usamajaved1305/80kw-pv-bess-autocad-dispatch/(list of files, cad)

Other CAD files:
drawings/PV-01 Mechanical Layout.dxf
drawings/PV-04 Single Line Diagram.dxf
drawings/PV-03 Battery Control and Performance.dxf
drawings/PV-01 Mechanical Layout.dwg
drawings/PV-03 Battery Control and Performance.dwg
drawings/PV-04 Single Line Diagram.dwg
