usamajaved1305/80kw-pv-bess-autocad-dispatch/drawings/PV-03 Battery Control and Performance.pdf

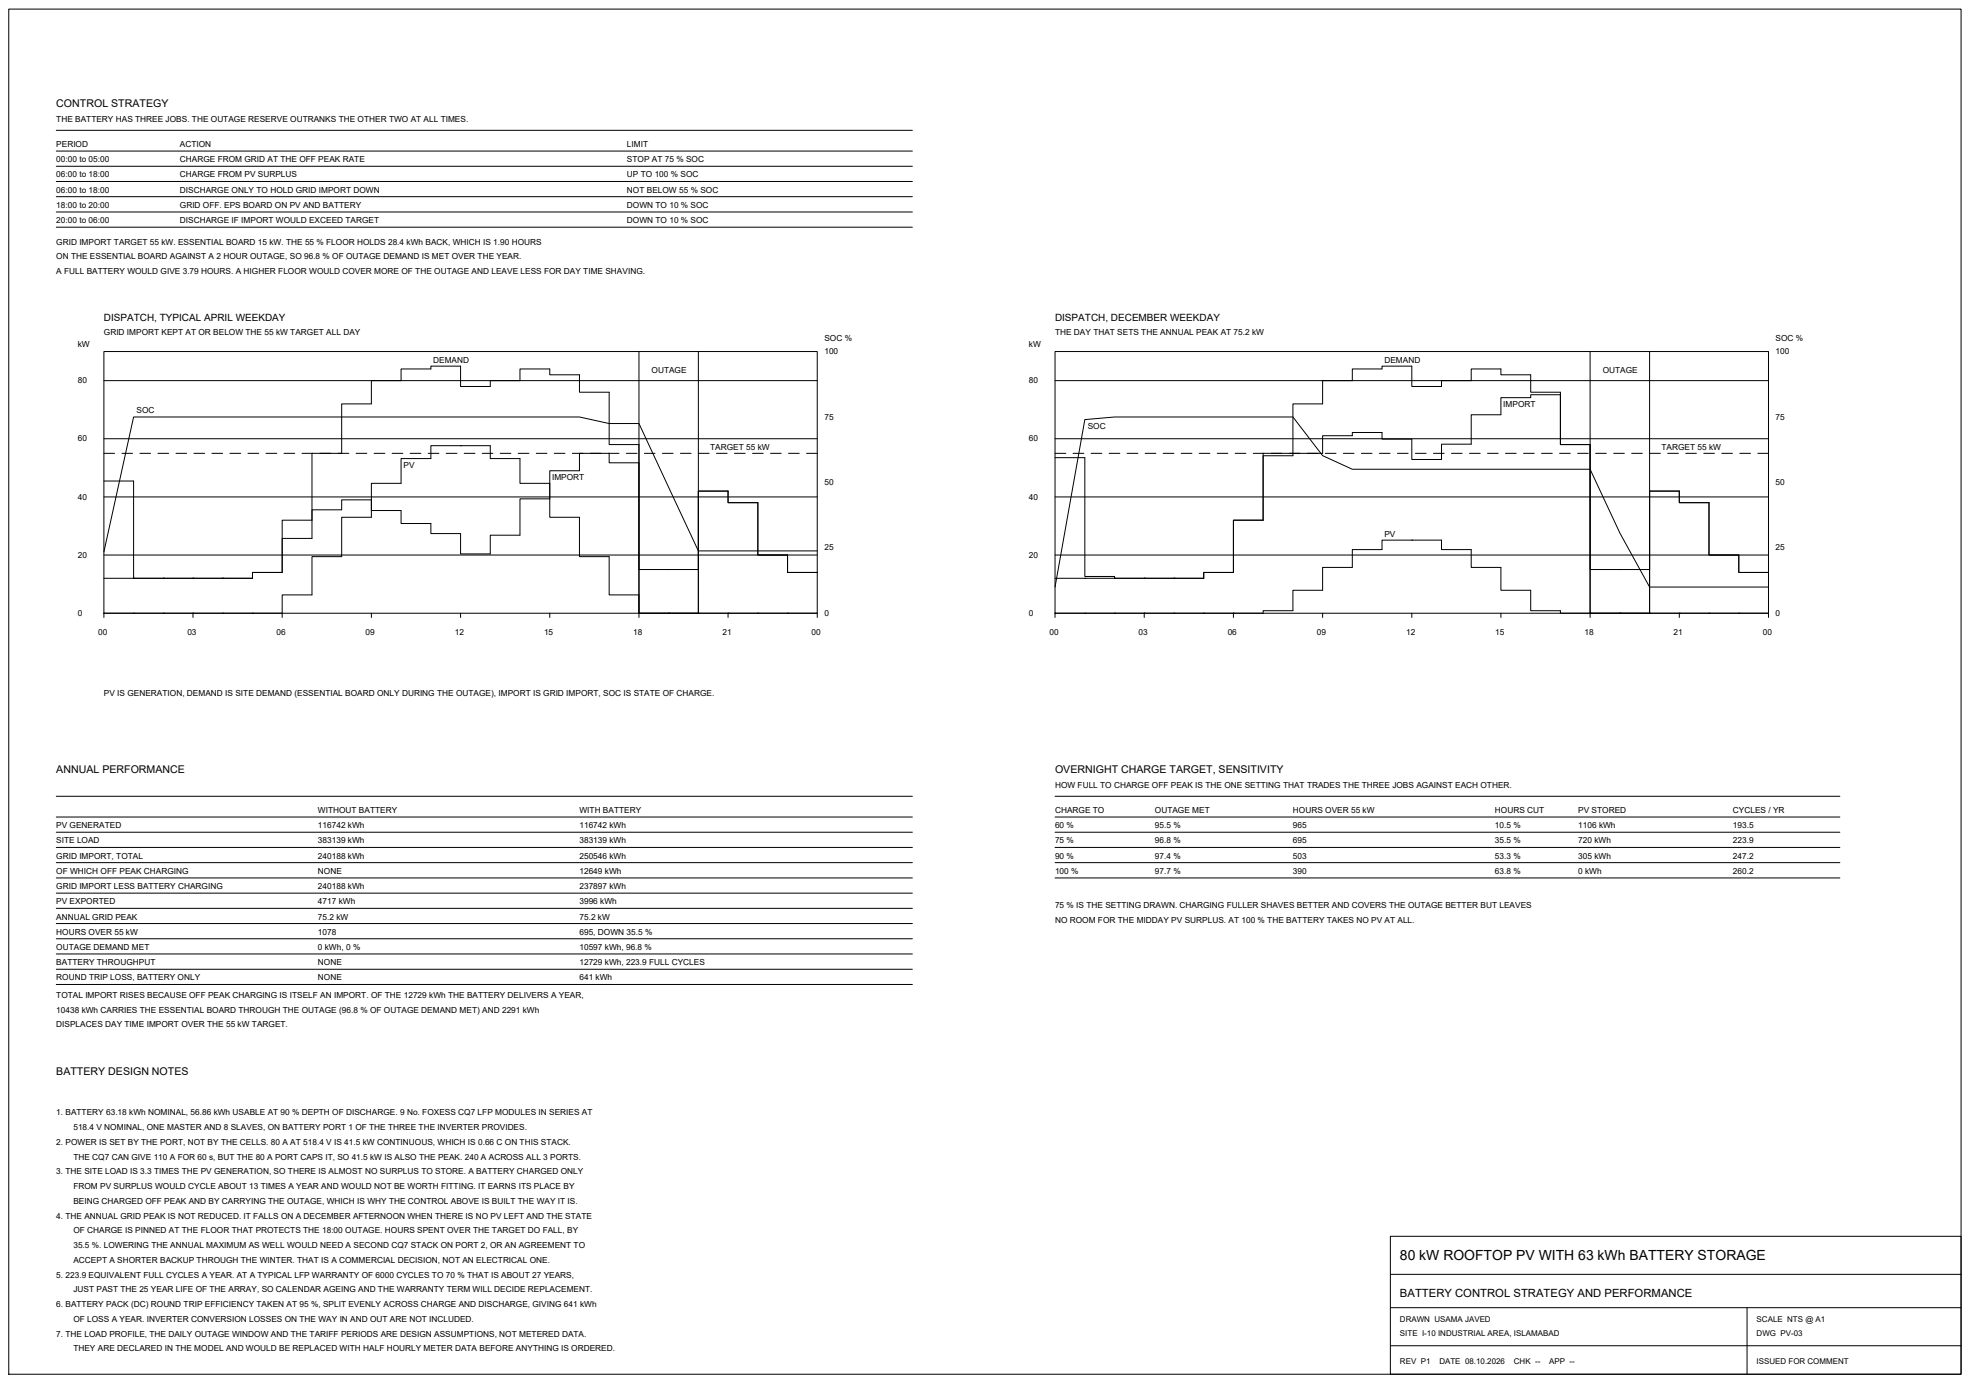
[picture p8: page 1]
CONTROL STRATEGY; CHARGE FROM GRID AT THE OFF PEAK RATE; STOP AT 75 % SOC; CHARGE FROM PV SURPLUS; UP TO 100 % SOC; DISCHARGE ONLY TO HOLD GRID IMPORT DOWN; NOT BELOW 55 % SOC; GRID OFF. EPS BOARD ON PV AND BATTERY; DOWN TO 10 % SOC; DISCHARGE IF IMPORT WOULD EXCEED TARGET; SOC %; TARGET 55 kW; ANNUAL PERFORMANCE; WITHOUT BATTERY; WITH BATTERY; PV GENERATED; 116742 kWh; SITE LOAD; 383139 kWh; GRID IMPORT, TOTAL; 240188 kWh; 250546 kWh; OF WHICH OFF PEAK CHARGING; NONE; 12649 kWh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

THE BATTERY HAS THREE JOBS. THE OUTAGE RESERVE OUTRANKS THE OTHER TWO AT ALL TIMES.

GRID IMPORT TARGET 55 kW. ESSENTIAL BOARD 15 kW. THE 55 % FLOOR HOLDS 28.4 kWh BACK, WHICH IS 1.90 HOURS
ON THE ESSENTIAL BOARD AGAINST A 2 HOUR OUTAGE, SO 96.8 % OF OUTAGE DEMAND IS MET OVER THE YEAR.
A FULL BATTERY WOULD GIVE 3.79 HOURS. A HIGHER FLOOR WOULD COVER MORE OF THE OUTAGE AND LEAVE LESS FOR DAY TIME SHAVING.

DISPATCH, TYPICAL APRIL WEEKDAY

DISPATCH, DECEMBER WEEKDAY

GRID IMPORT KEPT AT OR BELOW THE 55 kW TARGET ALL DAY

THE DAY THAT SETS THE ANNUAL PEAK AT 75.2 kW

PV IS GENERATION, DEMAND IS SITE DEMAND (ESSENTIAL BOARD ONLY DURING THE OUTAGE), IMPORT IS GRID IMPORT, SOC IS STATE OF CHARGE.

OVERNIGHT CHARGE TARGET, SENSITIVITY

HOW FULL TO CHARGE OFF PEAK IS THE ONE SETTING THAT TRADES THE THREE JOBS AGAINST EACH OTHER.

75 % IS THE SETTING DRAWN. CHARGING FULLER SHAVES BETTER AND COVERS THE OUTAGE BETTER BUT LEAVES
NO ROOM FOR THE MIDDAY PV SURPLUS. AT 100 % THE BATTERY TAKES NO PV AT ALL.

TOTAL IMPORT RISES BECAUSE OFF PEAK CHARGING IS ITSELF AN IMPORT. OF THE 12729 kWh THE BATTERY DELIVERS A YEAR,
10438 kWh CARRIES THE ESSENTIAL BOARD THROUGH THE OUTAGE (96.8 % OF OUTAGE DEMAND MET) AND 2291 kWh
DISPLACES DAY TIME IMPORT OVER THE 55 kW TARGET.

BATTERY DESIGN NOTES

1. BATTERY 63.18 kWh NOMINAL, 56.86 kWh USABLE AT 90 % DEPTH OF DISCHARGE. 9 No. FOXESS CQ7 LFP MODULES IN SERIES AT
518.4 V NOMINAL, ONE MASTER AND 8 SLAVES, ON BATTERY PORT 1 OF THE THREE THE INVERTER PROVIDES.
2. POWER IS SET BY THE PORT, NOT BY THE CELLS. 80 A AT 518.4 V IS 41.5 kW CONTINUOUS, WHICH IS 0.66 C ON THIS STACK.
THE CQ7 CAN GIVE 110 A FOR 60 s, BUT THE 80 A PORT CAPS IT, SO 41.5 kW IS ALSO THE PEAK. 240 A ACROSS ALL 3 PORTS.
3. THE SITE LOAD IS 3.3 TIMES THE PV GENERATION, SO THERE IS ALMOST NO SURPLUS TO STORE. A BATTERY CHARGED ONLY
FROM PV SURPLUS WOULD CYCLE ABOUT 13 TIMES A YEAR AND WOULD NOT BE WORTH FITTING. IT EARNS ITS PLACE BY
BEING CHARGED OFF PEAK AND BY CARRYING THE OUTAGE, WHICH IS WHY THE CONTROL ABOVE IS BUILT THE WAY IT IS.
4. THE ANNUAL GRID PEAK IS NOT REDUCED. IT FALLS ON A DECEMBER AFTERNOON WHEN THERE IS NO PV LEFT AND THE STATE
OF CHARGE IS PINNED AT THE FLOOR THAT PROTECTS THE 18:00 OUTAGE. HOURS SPENT OVER THE TARGET DO FALL, BY
35.5 %. LOWERING THE ANNUAL MAXIMUM AS WELL WOULD NEED A SECOND CQ7 STACK ON PORT 2, OR AN AGREEMENT TO
ACCEPT A SHORTER BACKUP THROUGH THE WINTER. THAT IS A COMMERCIAL DECISION, NOT AN ELECTRICAL ONE.
5. 223.9 EQUIVALENT FULL CYCLES A YEAR. AT A TYPICAL LFP WARRANTY OF 6000 CYCLES TO 70 % THAT IS ABOUT 27 YEARS,
JUST PAST THE 25 YEAR LIFE OF THE ARRAY, SO CALENDAR AGEING AND THE WARRANTY TERM WILL DECIDE REPLACEMENT.
6. BATTERY PACK (DC) ROUND TRIP EFFICIENCY TAKEN AT 95 %, SPLIT EVENLY ACROSS CHARGE AND DISCHARGE, GIVING 641 kWh
OF LOSS A YEAR. INVERTER CONVERSION LOSSES ON THE WAY IN AND OUT ARE NOT INCLUDED.
7. THE LOAD PROFILE, THE DAILY OUTAGE WINDOW AND THE TARIFF PERIODS ARE DESIGN ASSUMPTIONS, NOT METERED DATA.
THEY ARE DECLARED IN THE MODEL AND WOULD BE REPLACED WITH HALF HOURLY METER DATA BEFORE ANYTHING IS ORDERED.

80 kW ROOFTOP PV WITH 63 kWh BATTERY STORAGE

BATTERY CONTROL STRATEGY AND PERFORMANCE

DRAWN USAMA JAVED SITE I-10 INDUSTRIAL AREA, ISLAMABAD | SCALE NTS @ A1 DWG PV-03

REV P1 DATE 08.10.2026 CHK -- APP -- | ISSUED FOR COMMENT
