usamajaved1305/80kw-pv-bess-autocad-dispatch/drawings/PV-01 Mechanical Layout.pdf

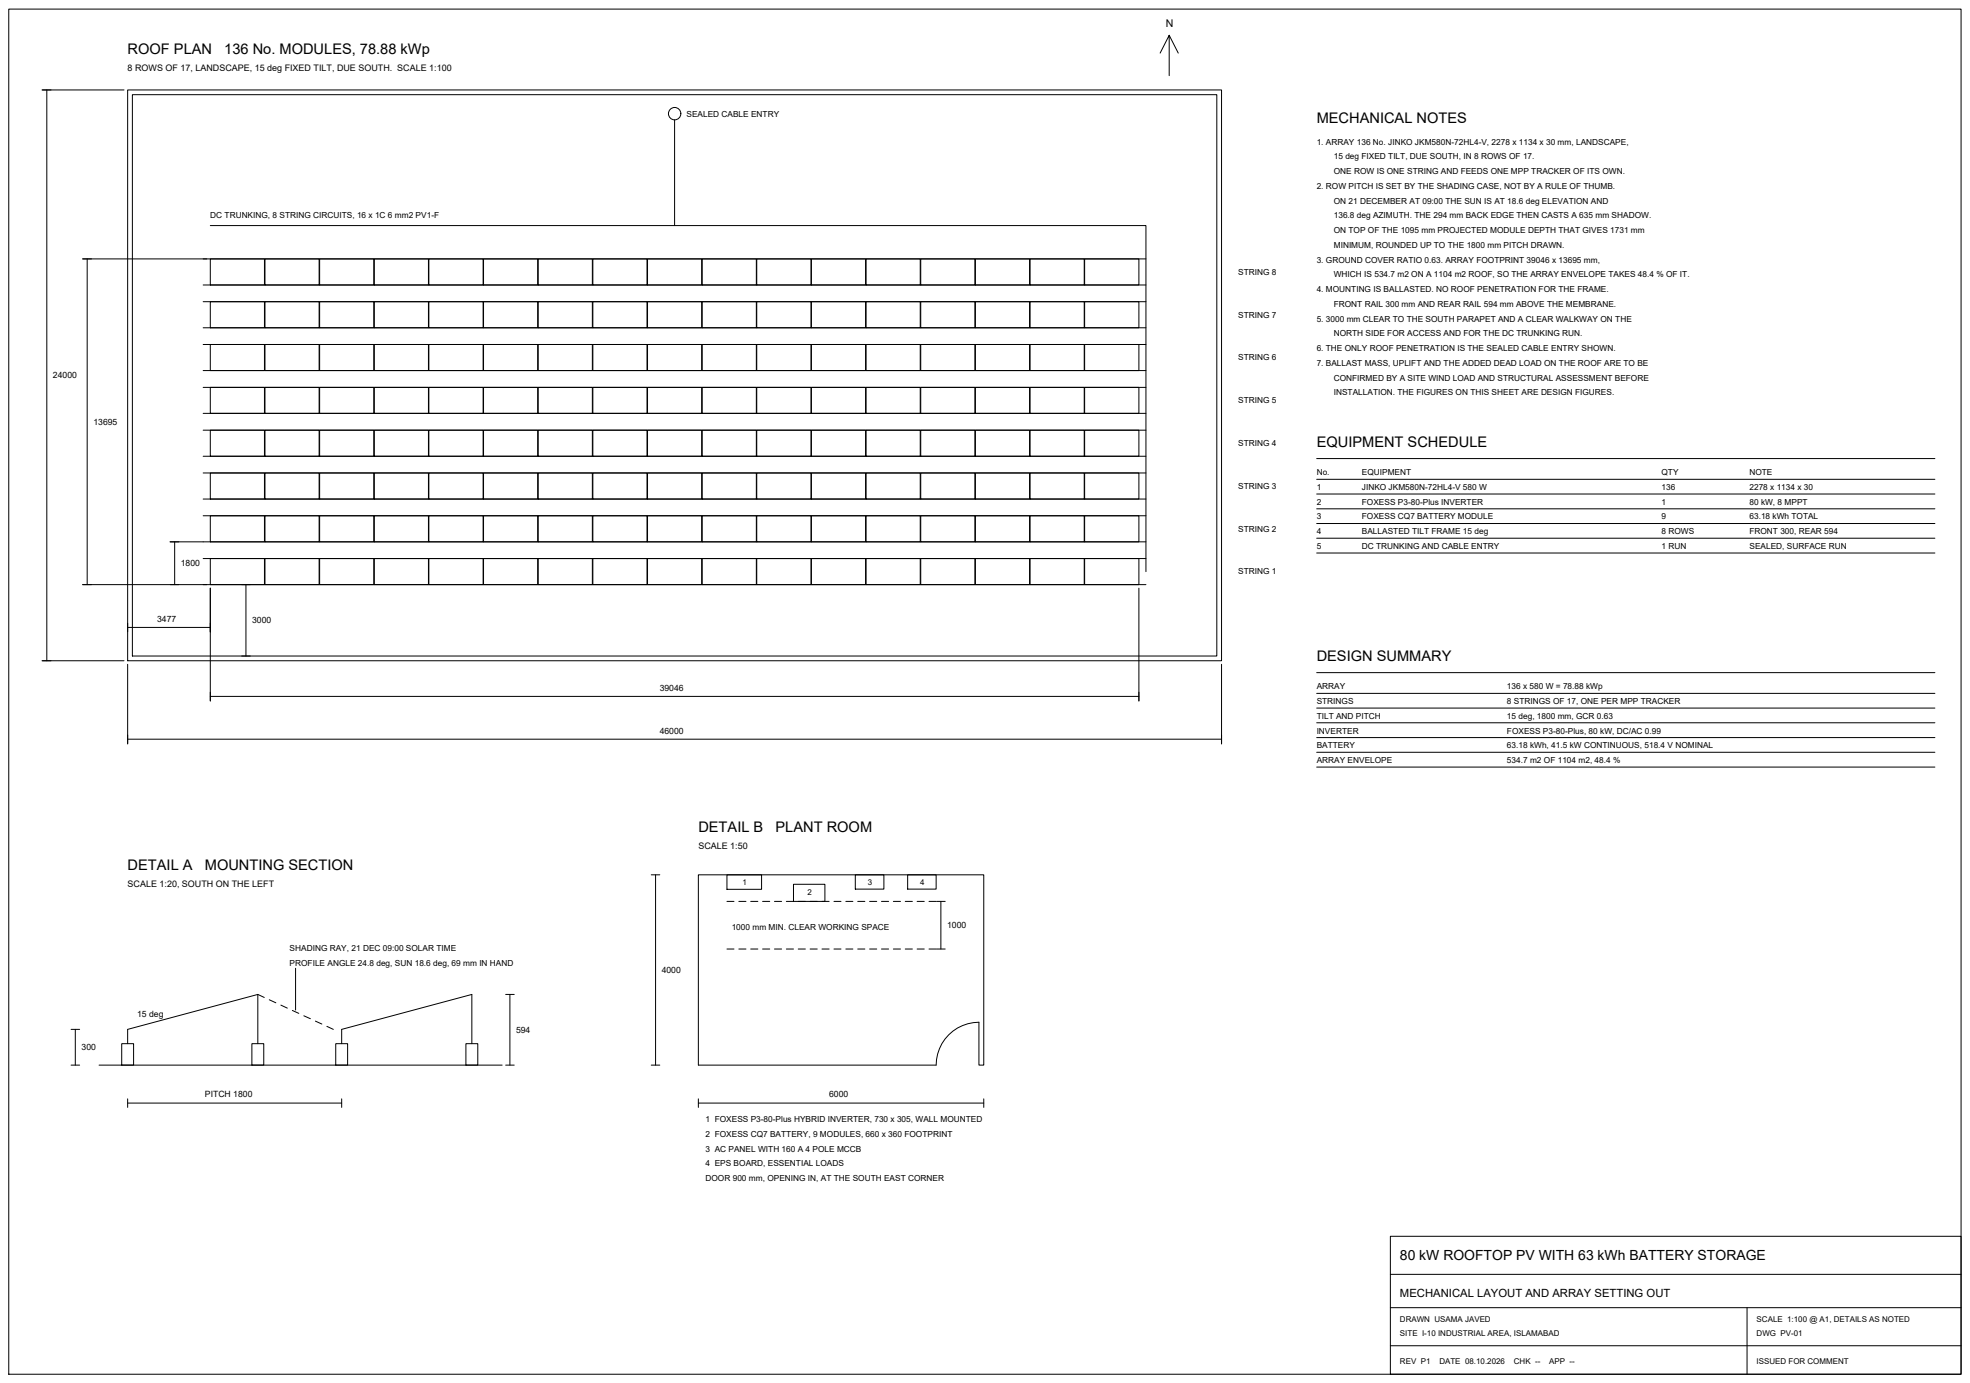
[picture p9: page 1]
STRING 1; STRING 2; STRING 3; STRING 4; STRING 5; STRING 6; STRING 7; STRING 8; 15 deg; PITCH 1800; SCALE 1:50; MECHANICAL NOTES; EQUIPMENT SCHEDULE; JINKO JKM580N-72HL4-V 580 W; FOXESS P3-80-Plus INVERTER; 80 kW, 8 MPPT; FOXESS CQ7 BATTERY MODULE; 63.18 kWh TOTAL; BALLASTED TILT FRAME 15 deg; 8 ROWS; FRONT 300, REAR 594; DC TRUNKING AND CABLE ENTRY; 1 RUN; SEALED, SURFACE RUN; DESIGN SUMMARY; ARRAY; 136 x 580 W = 78.88 kWp; STRINGS; 8 STRINGS OF 17, ONE PER MPP TRACKER; TILT AND PITCH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

ROOF PLAN 136 No. MODULES, 78.88 kWp

8 ROWS OF 17, LANDSCAPE, 15 deg FIXED TILT, DUE SOUTH. SCALE 1:100

SEALED CABLE ENTRY

1. ARRAY 136 No. JINKO JKM580N-72HL4-V, 2278 x 1134 x 30 mm, LANDSCAPE,
15 deg FIXED TILT, DUE SOUTH, IN 8 ROWS OF 17.
ONE ROW IS ONE STRING AND FEEDS ONE MPP TRACKER OF ITS OWN.
2. ROW PITCH IS SET BY THE SHADING CASE, NOT BY A RULE OF THUMB.
ON 21 DECEMBER AT 09:00 THE SUN IS AT 18.6 deg ELEVATION AND
136.8 deg AZIMUTH. THE 294 mm BACK EDGE THEN CASTS A 635 mm SHADOW.
ON TOP OF THE 1095 mm PROJECTED MODULE DEPTH THAT GIVES 1731 mm
MINIMUM, ROUNDED UP TO THE 1800 mm PITCH DRAWN.
3. GROUND COVER RATIO 0.63. ARRAY FOOTPRINT 39046 x 13695 mm,
WHICH IS 534.7 m2 ON A 1104 m2 ROOF, SO THE ARRAY ENVELOPE TAKES 48.4 % OF IT.
4. MOUNTING IS BALLASTED. NO ROOF PENETRATION FOR THE FRAME.
FRONT RAIL 300 mm AND REAR RAIL 594 mm ABOVE THE MEMBRANE.
5. 3000 mm CLEAR TO THE SOUTH PARAPET AND A CLEAR WALKWAY ON THE
NORTH SIDE FOR ACCESS AND FOR THE DC TRUNKING RUN.
6. THE ONLY ROOF PENETRATION IS THE SEALED CABLE ENTRY SHOWN.
7. BALLAST MASS, UPLIFT AND THE ADDED DEAD LOAD ON THE ROOF ARE TO BE
CONFIRMED BY A SITE WIND LOAD AND STRUCTURAL ASSESSMENT BEFORE
INSTALLATION. THE FIGURES ON THIS SHEET ARE DESIGN FIGURES.

DC TRUNKING, 8 STRING CIRCUITS, 16 x 1C 6 mm2 PV1-F

DETAIL B PLANT ROOM

DETAIL A MOUNTING SECTION

SCALE 1:20, SOUTH ON THE LEFT

1000 mm MIN. CLEAR WORKING SPACE

SHADING RAY, 21 DEC 09:00 SOLAR TIME
PROFILE ANGLE 24.8 deg, SUN 18.6 deg, 69 mm IN HAND

1 FOXESS P3-80-Plus HYBRID INVERTER, 730 x 305, WALL MOUNTED
2 FOXESS CQ7 BATTERY, 9 MODULES, 660 x 360 FOOTPRINT
3 AC PANEL WITH 160 A 4 POLE MCCB
4 EPS BOARD, ESSENTIAL LOADS
DOOR 900 mm, OPENING IN, AT THE SOUTH EAST CORNER

80 kW ROOFTOP PV WITH 63 kWh BATTERY STORAGE

MECHANICAL LAYOUT AND ARRAY SETTING OUT

DRAWN USAMA JAVED SITE I-10 INDUSTRIAL AREA, ISLAMABAD | SCALE 1:100 @ A1, DETAILS AS NOTED DWG PV-01

REV P1 DATE 08.10.2026 CHK -- APP -- | ISSUED FOR COMMENT
