usamajaved1305/80kw-pv-bess-autocad-dispatch/drawings/PV-04 Single Line Diagram.pdf

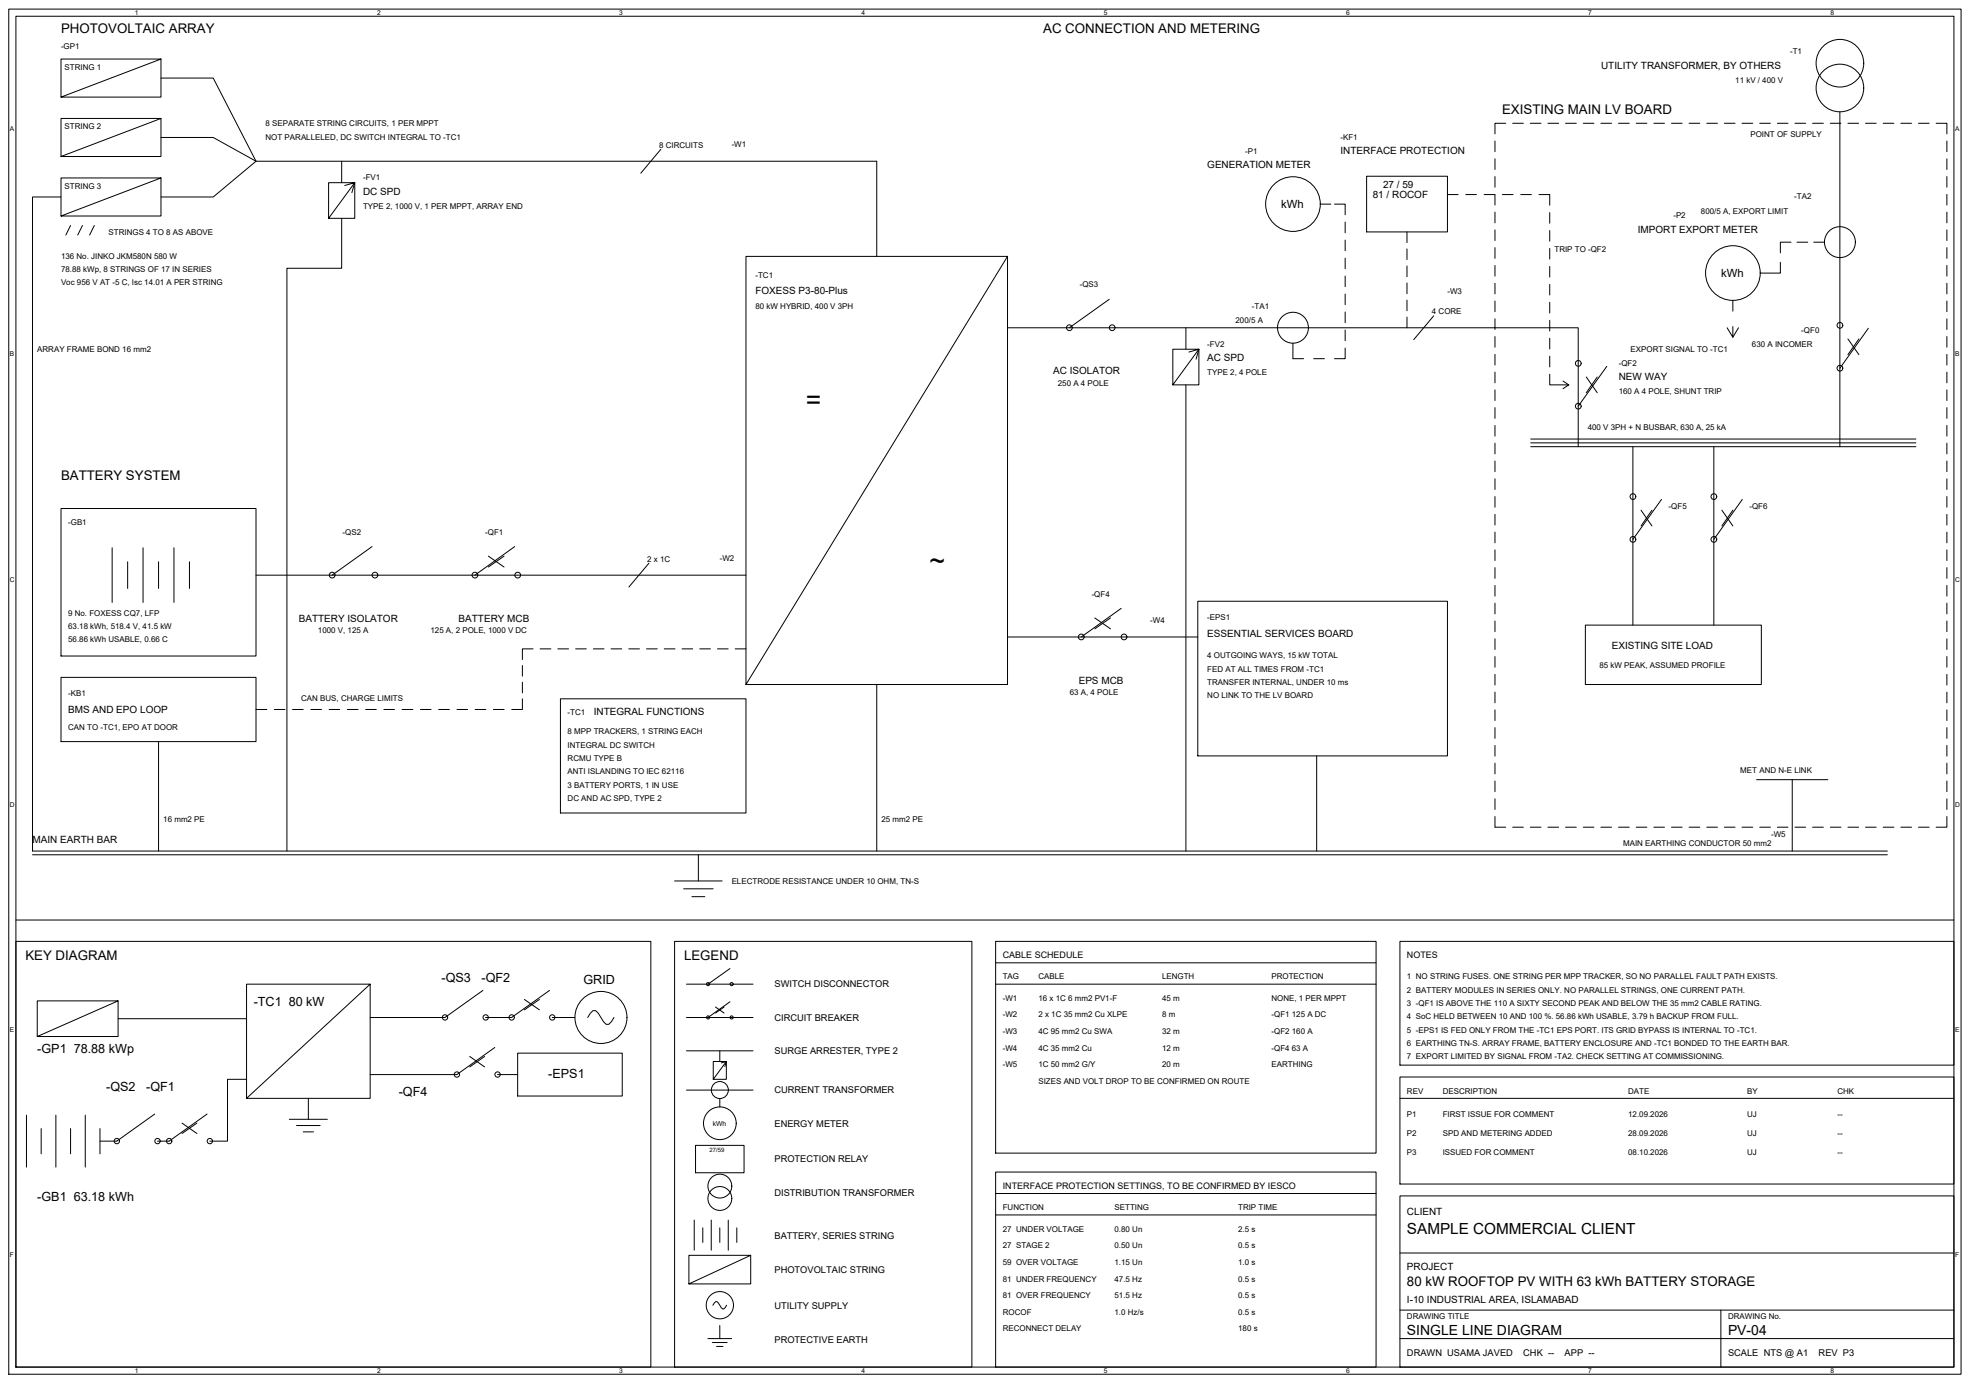
[picture p10: page 1]
PHOTOVOLTAIC ARRAY; STRING 1; STRING 2; STRING 3; DC SPD; 8 CIRCUITS; BATTERY SYSTEM; BATTERY ISOLATOR; BATTERY MCB; 125 A, 2 POLE, 1000 V DC; FOXESS P3-80-Plus; 80 kW HYBRID, 400 V 3PH; -TC1 INTEGRAL FUNCTIONS; AC ISOLATOR; 250 A 4 POLE; AC SPD; TYPE 2, 4 POLE; GENERATION METER; 27 / 59 81 / ROCOF; INTERFACE PROTECTION; TRIP TO -QF2; 4 CORE; 400 V 3PH + N BUSBAR, 630 A, 25 kA; 800/5 A, EXPORT LIMIT; 630 A INCOMER; EPS MCB; 63 A, 4 POLE; KEY DIAGRAM; -GP1 78.88 kWp; -GB1 63.18 kWh; GRID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

AC CONNECTION AND METERING

UTILITY TRANSFORMER, BY OTHERS

EXISTING MAIN LV BOARD

8 SEPARATE STRING CIRCUITS, 1 PER MPPT
NOT PARALLELED, DC SWITCH INTEGRAL TO -TC1

POINT OF SUPPLY

TYPE 2, 1000 V, 1 PER MPPT, ARRAY END

STRINGS 4 TO 8 AS ABOVE

IMPORT EXPORT METER

136 No. JINKO JKM580N 580 W
78.88 kWp, 8 STRINGS OF 17 IN SERIES
Voc 956 V AT -5 C, Isc 14.01 A PER STRING

ARRAY FRAME BOND 16 mm2

EXPORT SIGNAL TO -TC1
NEW WAY

160 A 4 POLE, SHUNT TRIP

9 No. FOXESS CQ7, LFP
63.18 kWh, 518.4 V, 41.5 kW
56.86 kWh USABLE, 0.66 C

-EPS1
ESSENTIAL SERVICES BOARD

EXISTING SITE LOAD

4 OUTGOING WAYS, 15 kW TOTAL
FED AT ALL TIMES FROM -TC1
TRANSFER INTERNAL, UNDER 10 ms
NO LINK TO THE LV BOARD

85 kW PEAK, ASSUMED PROFILE

BMS AND EPO LOOP

CAN BUS, CHARGE LIMITS

CAN TO -TC1, EPO AT DOOR

8 MPP TRACKERS, 1 STRING EACH
INTEGRAL DC SWITCH
RCMU TYPE B
ANTI ISLANDING TO IEC 62116
3 BATTERY PORTS, 1 IN USE
DC AND AC SPD, TYPE 2

MET AND N-E LINK

MAIN EARTH BAR

MAIN EARTHING CONDUCTOR 50 mm2

ELECTRODE RESISTANCE UNDER 10 OHM, TN-S

1 NO STRING FUSES. ONE STRING PER MPP TRACKER, SO NO PARALLEL FAULT PATH EXISTS.
2 BATTERY MODULES IN SERIES ONLY. NO PARALLEL STRINGS, ONE CURRENT PATH.
3 -QF1 IS ABOVE THE 110 A SIXTY SECOND PEAK AND BELOW THE 35 mm2 CABLE RATING.
4 SoC HELD BETWEEN 10 AND 100 %. 56.86 kWh USABLE, 3.79 h BACKUP FROM FULL.
5 -EPS1 IS FED ONLY FROM THE -TC1 EPS PORT. ITS GRID BYPASS IS INTERNAL TO -TC1.
6 EARTHING TN-S. ARRAY FRAME, BATTERY ENCLOSURE AND -TC1 BONDED TO THE EARTH BAR.
7 EXPORT LIMITED BY SIGNAL FROM -TA2. CHECK SETTING AT COMMISSIONING.

SURGE ARRESTER, TYPE 2

SIZES AND VOLT DROP TO BE CONFIRMED ON ROUTE

INTERFACE PROTECTION SETTINGS, TO BE CONFIRMED BY IESCO

CLIENT
SAMPLE COMMERCIAL CLIENT

BATTERY, SERIES STRING

PROJECT
80 kW ROOFTOP PV WITH 63 kWh BATTERY STORAGE

I-10 INDUSTRIAL AREA, ISLAMABAD

DRAWING TITLE SINGLE LINE DIAGRAM | DRAWING No. PV-04

DRAWN USAMA JAVED CHK -- APP -- | SCALE NTS @ A1 REV P3
